gregelectric/pluvio-grow-open/hardware/stl/README.md

# 3D-Printed Parts — Pluvio Grow M5

Eight printed parts for the confirmed M5 build. Print in PETG (or PLA), ~0.2 mm layers, 3–4 walls, ~25 % infill. Most parts are
designed to print **without supports** — the one exception is the **chassis-bottom
pockets**, which need supports. Orient the dome/shroud open-side-down.

> **Tested print.** These parts were printed on a **Bambu P1S / H2S** with a
> **0.6 mm nozzle**, in **PETG**, at ~**25 % infill**. The 0.6 mm nozzle prints
> the whole set comfortably; nothing here needs fine-nozzle detail.

| File | Part | Approx. size (mm) |
|---|---|---|
| `carousel_disk.stl` | 13-position metering disk | 210 × 210 × 27 |
| `housing_body.stl` | Main lower housing | 211 × 211 × 125 |
| `housing_shroud.stl` | Top cover / shroud | 211 × 211 × 231 |
| `base_plate.stl` | Base plate | 161 × 157 × 36 |
| `tank_platform.stl` | Reservoir platform | 200 × 200 × 30 |
| `dosing_spout.stl` | Dosing spout | 71 × 119 × 20 |
| `mcu_mount.stl` | MCU + scale mount | 30 × 40 × 85 |
| `leveling_shim.stl` | Leveling shim | 210 × 210 × 2 |
