gregelectric/pluvio-grow-open/hardware/stl/base_plate.stl

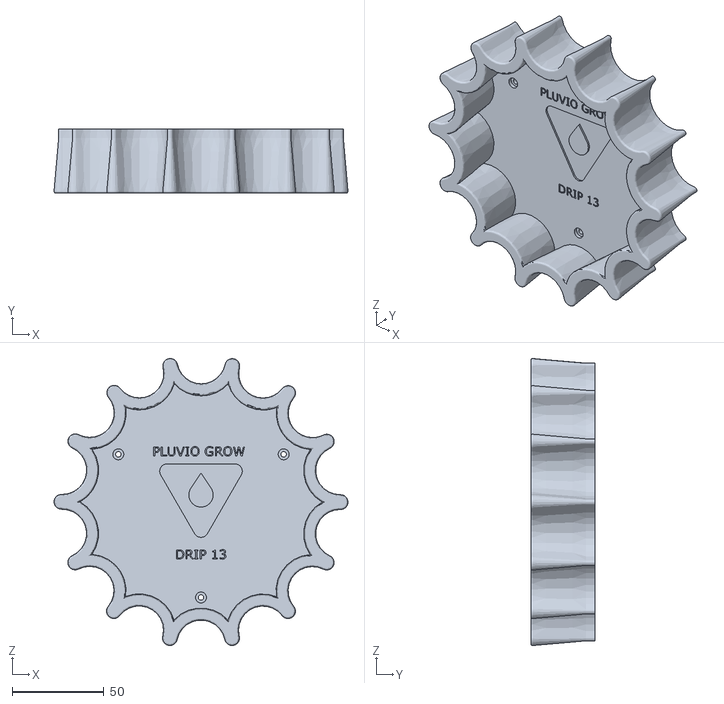
[picture p4: CAD file, 2026-10-11]
hardware/stl/base_plate.stl
160.1 x 35.0 x 156.3
