gregelectric/pluvio-grow-open/hardware/stl/housing_body.stl

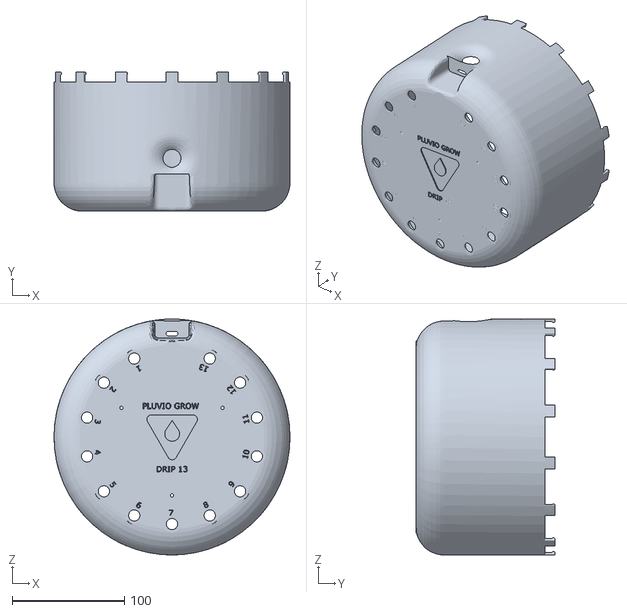
[picture p5: CAD file, 2026-10-11]
hardware/stl/housing_body.stl
210.0 x 124.0 x 210.0
