gregelectric/pluvio-grow-open/hardware/stl/housing_shroud.stl

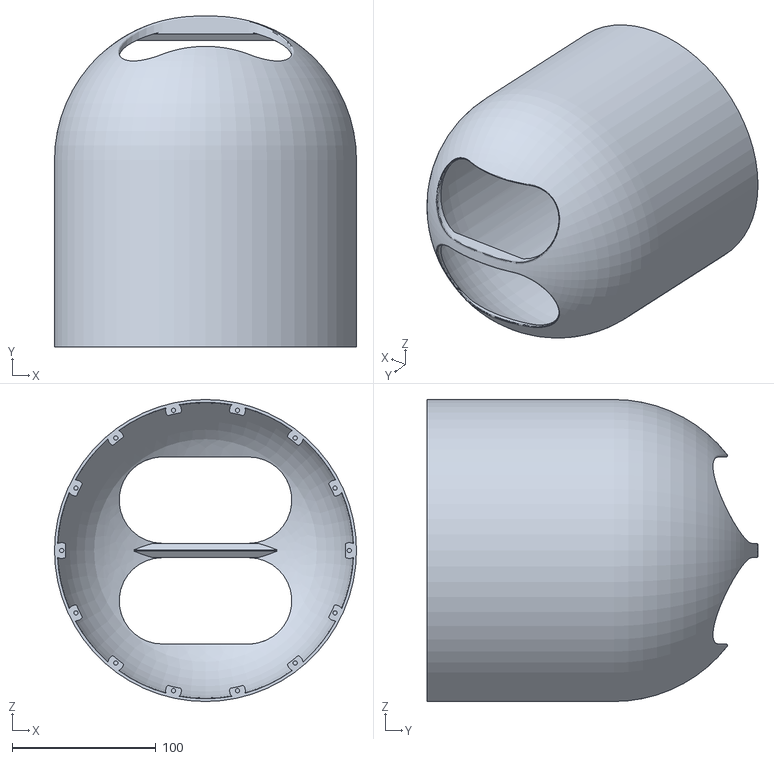
[picture p6: CAD file, 2026-10-11]
hardware/stl/housing_shroud.stl
210.0 x 230.0 x 210.0
