gregelectric/pluvio-grow-open/hardware/stl/mcu_mount.stl

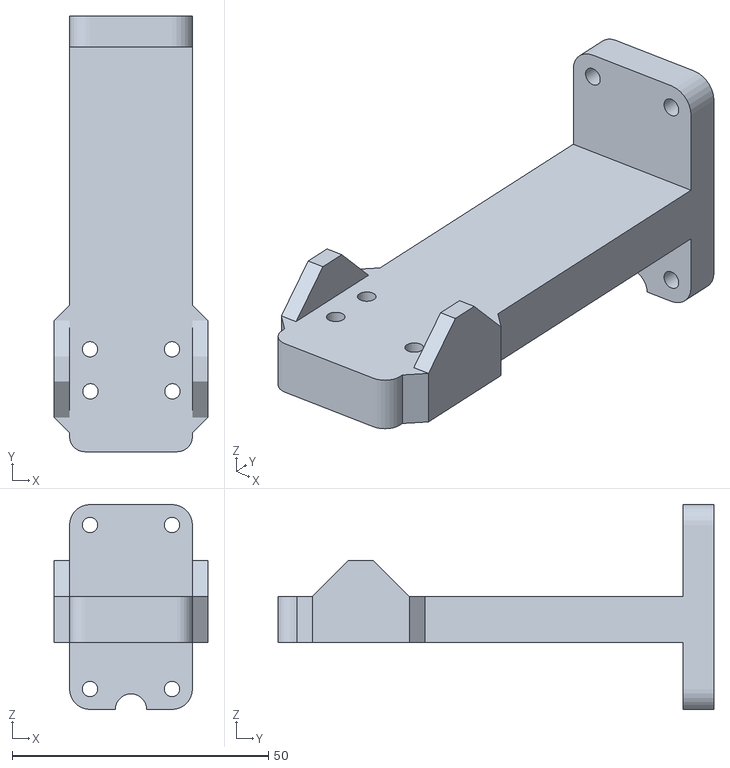
[picture p7: CAD file, 2026-10-11]
hardware/stl/mcu_mount.stl
30.0 x 85.0 x 40.0
