gregelectric/pluvio-grow-open/hardware/stl/tank_platform.stl

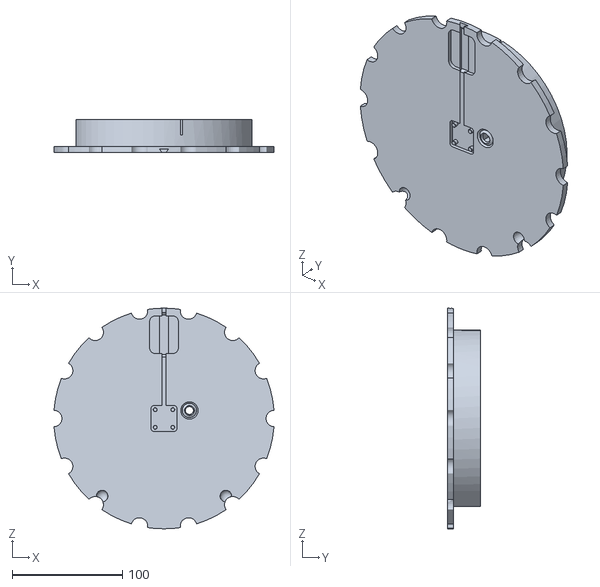
[picture p8: CAD file, 2026-10-11]
hardware/stl/tank_platform.stl
199.4 x 30.0 x 200.0
