gregelectric/pluvio-grow-open/hardware/stl/dosing_spout.stl

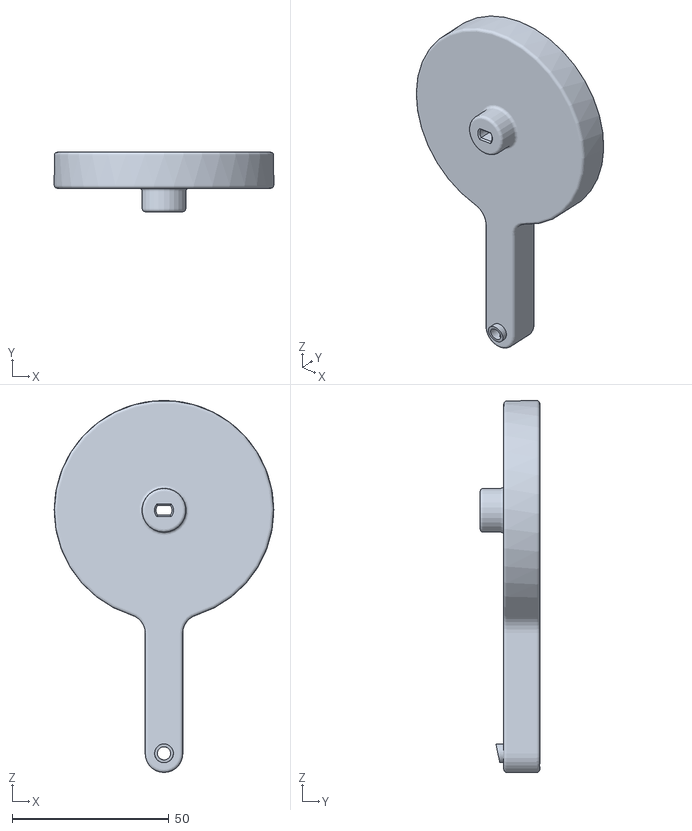
[picture p9: CAD file, 2026-10-11]
hardware/stl/dosing_spout.stl
70.0 x 19.0 x 118.6
