gregelectric/pluvio-grow-open/hardware/stl/carousel_disk.stl

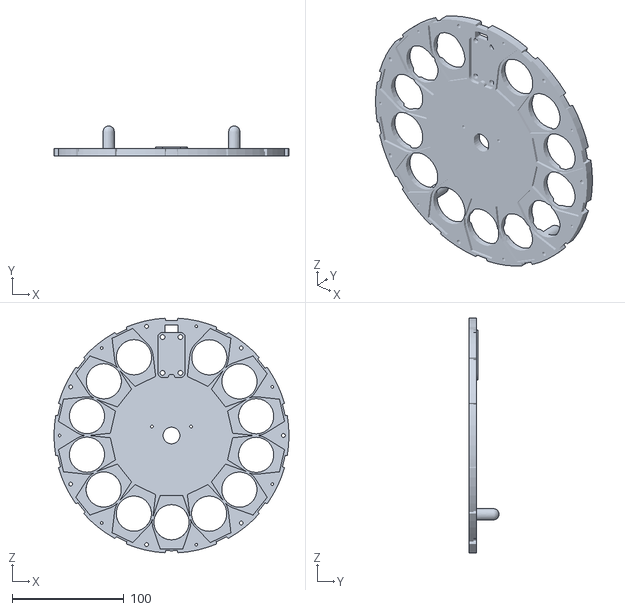
[picture p10: CAD file, 2026-10-11]
hardware/stl/carousel_disk.stl
210.0 x 27.0 x 209.7
