gregelectric/pluvio-grow-open/hardware/stl/leveling_shim.stl

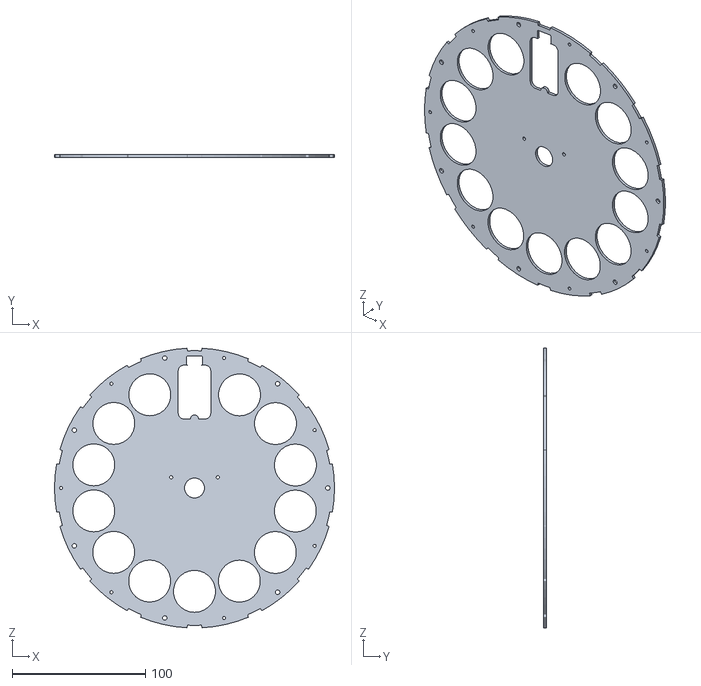
[picture p11: CAD file, 2026-10-11]
hardware/stl/leveling_shim.stl
210.0 x 2.00 x 209.7
