gregelectric/pluvio-grow-open/(commit log)

2026-10-11 Pluvio Grow M5 open build - initial public release
    [base_plate.stl, carousel_disk.stl, dosing_spout.stl, housing_body.stl, housing_shroud.stl, leveling_shim.stl, motor_mount.stl, tank_platform.stl]
2026-10-11 Open build: STL + document only (firmware held back until it builds)
    [mcu_mount.stl, motor_mount.stl]
